ea2809/empotrados/(commit log)

2017-03-20 Codigos en base de datos sqlite
2017-03-20 Generador de códgios
2017-03-23 Update _variables.scss
    Sacado de San Google
2017-03-23 Create _bootswatch.scss
    Para darle todo el estilo a la web
2017-03-23 Update app.scss
    Ya se supone que tendrá estilo (No lo he probado, estoy en github.com)
